Wth166017/stm32-temperature-fan-environmental-monitoring-system-/docs/IMG20260921170803.jpg

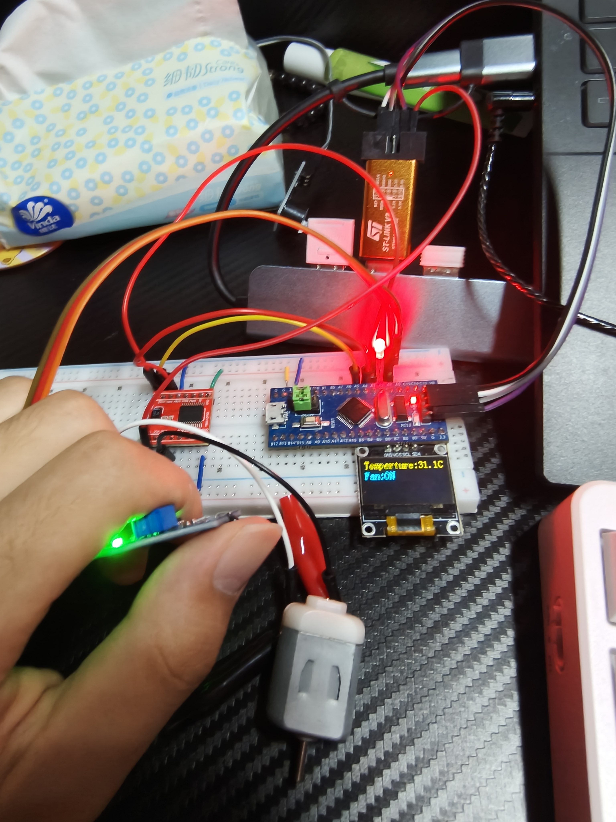
docs/IMG20260921170803.jpg
