Wth166017/stm32-temperature-fan-environmental-monitoring-system-/Hardware/Motor.c

#include "stm32f10x.h"                  // Device header
#include "config.h"                     // 全工程参数集中管理
void Motor_Init(void)
{
	RCC_APB2PeriphClockCmd(RCC_APB2Periph_GPIOA,ENABLE);
	RCC_APB1PeriphClockCmd(RCC_APB1Periph_TIM2,ENABLE);
	
	GPIO_InitTypeDef  GPIO_InitStruct;
	GPIO_InitStruct.GPIO_Mode = GPIO_Mode_AF_PP;     
	GPIO_InitStruct.GPIO_Pin = GPIO_Pin_3;
	GPIO_InitStruct.GPIO_Speed = GPIO_Speed_50MHz;
	GPIO_Init(GPIOA,&GPIO_InitStruct);
	GPIO_InitStruct.GPIO_Mode = GPIO_Mode_Out_PP;     
	GPIO_InitStruct.GPIO_Pin = GPIO_Pin_4 |GPIO_Pin_5;
	GPIO_InitStruct.GPIO_Speed = GPIO_Speed_50MHz;
	GPIO_Init(GPIOA,&GPIO_InitStruct);
	
	TIM_InternalClockConfig(TIM2);
	
	TIM_TimeBaseInitTypeDef  TIM_TimeBaseInitStruct;
	TIM_TimeBaseInitStruct.TIM_ClockDivision = TIM_CKD_DIV1;
	TIM_TimeBaseInitStruct.TIM_CounterMode = TIM_CounterMode_Up;
	TIM_TimeBaseInitStruct.TIM_Period = MOTOR_TIM_ARR;
	TIM_TimeBaseInitStruct.TIM_Prescaler = MOTOR_TIM_PSC;
	TIM_TimeBaseInitStruct.TIM_RepetitionCounter = 0;
	TIM_TimeBaseInit(TIM2, &TIM_TimeBaseInitStruct);

	TIM_OCInitTypeDef  TIM_OCInitStruct;
	TIM_OCStructInit(&TIM_OCInitStruct);
	TIM_OCInitStruct.TIM_OCMode = TIM_OCMode_PWM1;
	TIM_OCInitStruct.TIM_OCPolarity = TIM_OCPolarity_High;
	TIM_OCInitStruct.TIM_OutputState =  TIM_OutputState_Enable;
	TIM_OCInitStruct.TIM_Pulse = 0;
	TIM_OC4Init(TIM2,&TIM_OCInitStruct);
	
	TIM_Cmd(TIM2,ENABLE);

}	

void Motor_SetSpeed(int8_t Speed)
{
	
		GPIO_SetBits(GPIOA,GPIO_Pin_4);
		GPIO_ResetBits(GPIOA,GPIO_Pin_5);
		TIM_SetCompare4(TIM2,Speed);
}

void Motor_Stop(void)
{
	Motor_SetSpeed(0);
}
