Wth166017/stm32-temperature-fan-environmental-monitoring-system-/(commit log)

2026-09-21 feat: STM32 智能温控风扇系统初版
    - NTC热敏电阻温度采集(ADC+B值公式)
    - OLED实时显示温度与风扇状态
    - TB6612直流电机PWM驱动(滞回控制 30℃开/29℃关)
    - 非阻塞LED闪烁(TIM3 1ms节拍)
    - config.h集中管理所有参数
    - docs: 开发踩坑记录
    - README: 项目说明文档
2026-10-10 feat: 迭代DS18B20数字测温、按键菜单与JDY-31蓝牙指令控制
    - DS18B20单总线驱动替换NTC（三状态非阻塞）
    - 双按键菜单（消抖/短按/长按恢复默认）
    - USART1中断接收+行缓冲，手机文本指令 ON/OFF/SPD 并回复确认
    - 串口周期上报温度，间隔 SERIAL_SEND_PERIOD_MS 可配置
    - 更新 README 与开发踩坑记录（坑21-30）
